Sajid-Ali-Imperial/Contact-Tracing-Wearable-FYP/PCB Design Documents/pcb_fabriacted.png

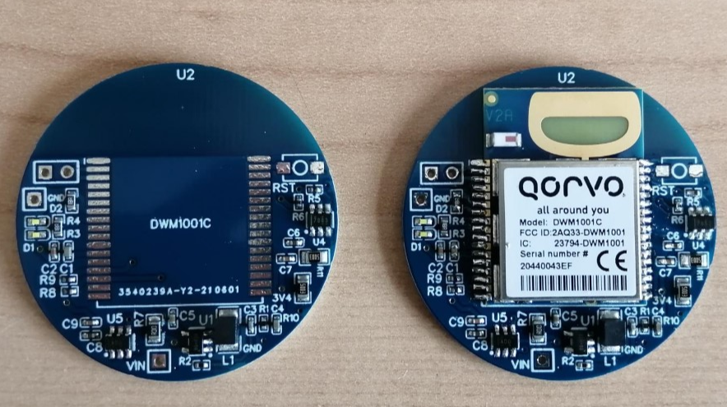
PCB Design Documents/pcb_fabriacted.png
