Sajid-Ali-Imperial/Contact-Tracing-Wearable-FYP/Covid Track App/Screenshots/Home Page 1.png

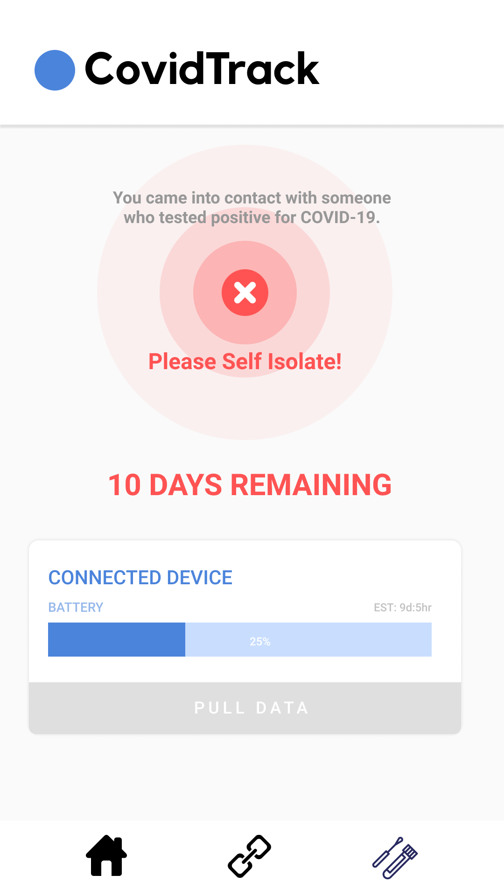
Covid Track App/Screenshots/Home Page 1.png
