Sajid-Ali-Imperial/Contact-Tracing-Wearable-FYP/Covid Track App/Screenshots/Home Page 2.png

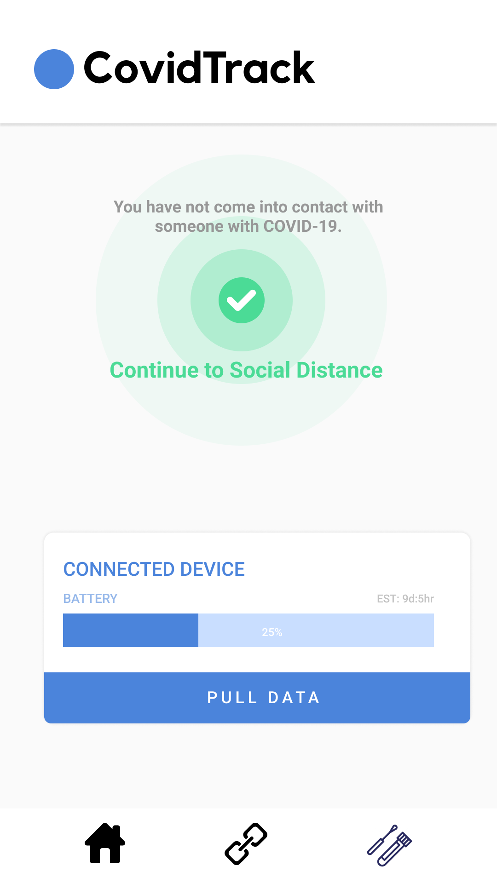
Covid Track App/Screenshots/Home Page 2.png
