Sajid-Ali-Imperial/Contact-Tracing-Wearable-FYP/Covid Track App/Screenshots/Link Device Disconnect.png

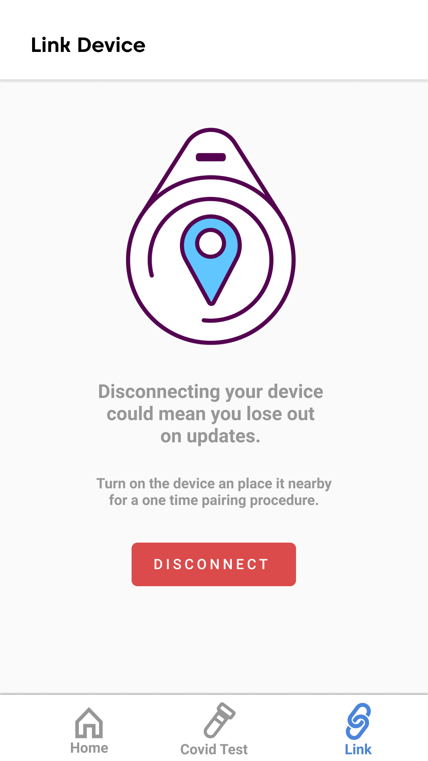
Covid Track App/Screenshots/Link Device Disconnect.png
