Sajid-Ali-Imperial/Contact-Tracing-Wearable-FYP/Covid Track App/Screenshots/Login Page.png

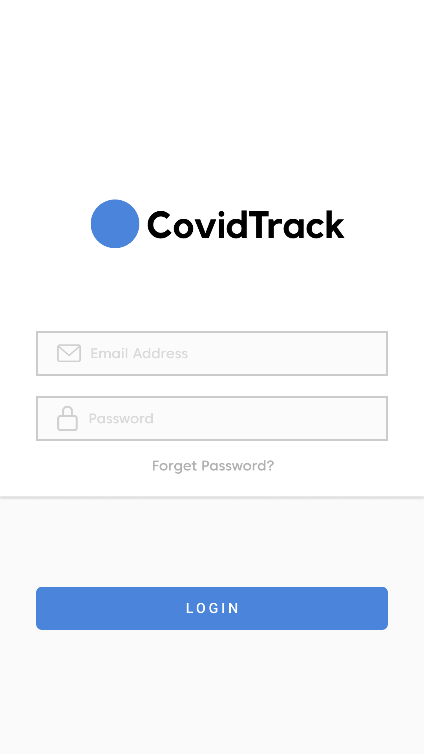
Covid Track App/Screenshots/Login Page.png
