Sajid-Ali-Imperial/Contact-Tracing-Wearable-FYP/Device Casing Model/battery_holder.stl

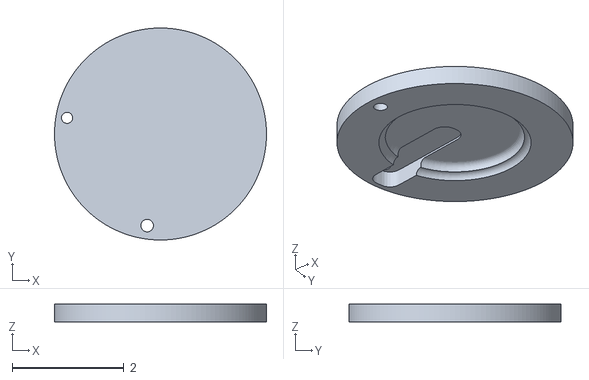
[picture p31: CAD file, 2021-06-16]
Device Casing Model/battery_holder.stl
3.80 x 3.80 x 0.318
