Sajid-Ali-Imperial/Contact-Tracing-Wearable-FYP/Device Casing Model/back.stl

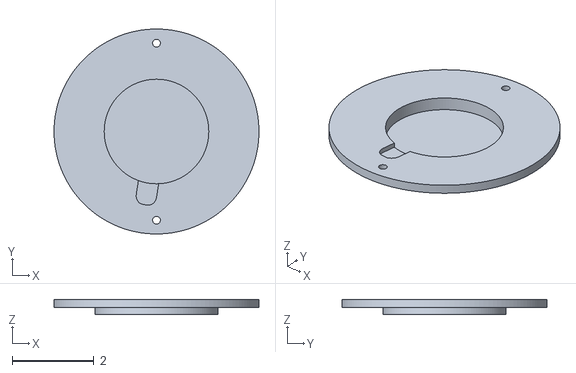
[picture p32: CAD file, 2021-06-16]
Device Casing Model/back.stl
5.00 x 5.00 x 0.367
