Sajid-Ali-Imperial/Contact-Tracing-Wearable-FYP/Device Casing Model/front.stl

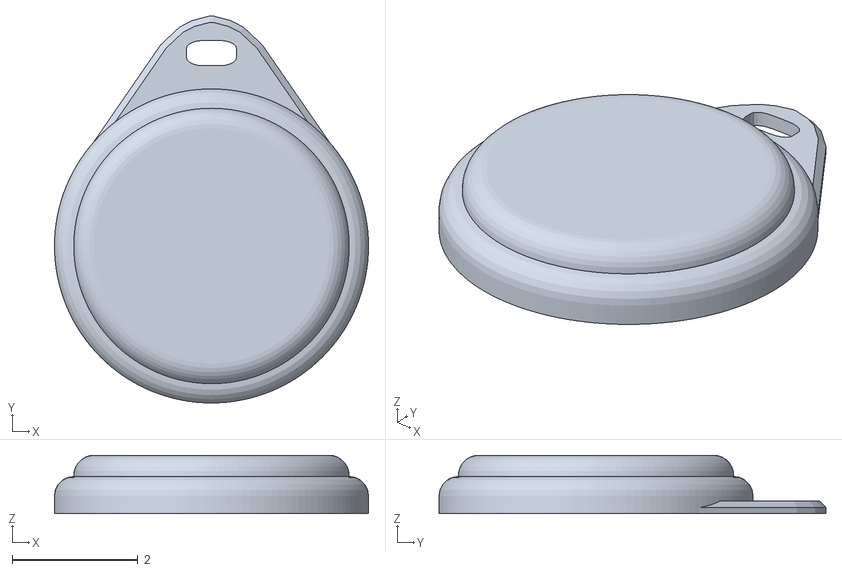
[picture p33: CAD file, 2021-06-16]
Device Casing Model/front.stl
5.00 x 6.16 x 0.93
