Sajid-Ali-Imperial/Contact-Tracing-Wearable-FYP/(list of files, cad)

Other CAD files:
Device Casing Model/device_casing.blend
