Sajid-Ali-Imperial/Contact-Tracing-Wearable-FYP/Covid Track App/Screenshots/Covid Test Input.png

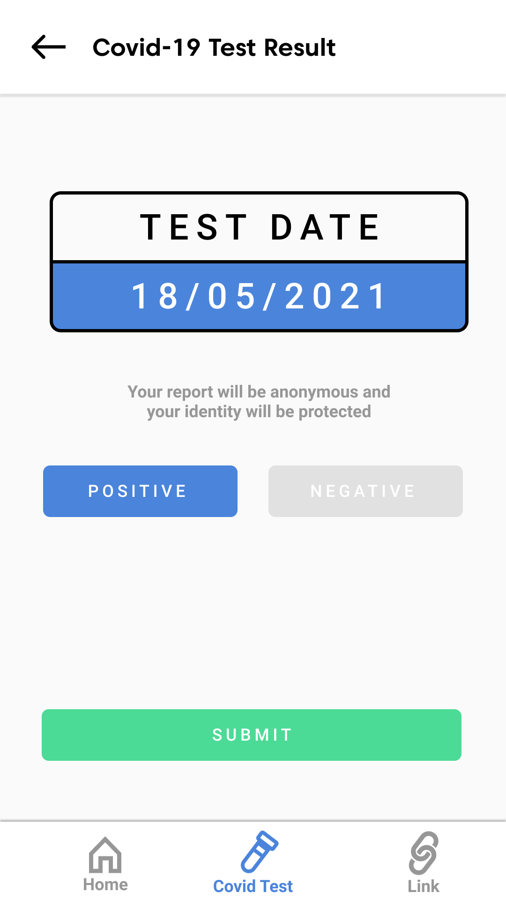
Covid Track App/Screenshots/Covid Test Input.png
