Sajid-Ali-Imperial/Contact-Tracing-Wearable-FYP/Covid Track App/Screenshots/Covid Test Page.png

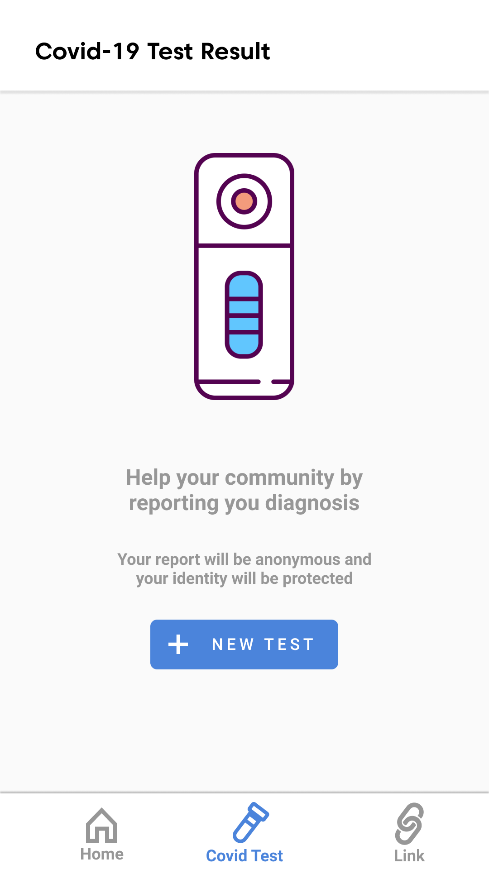
Covid Track App/Screenshots/Covid Test Page.png
