Sajid-Ali-Imperial/Contact-Tracing-Wearable-FYP/PCB Design Documents/Schematic_nRF52 Example Board_2021-06-15.pdf

## DWM1001 MODULE

# BATTERY MONITOR V_SHUNT

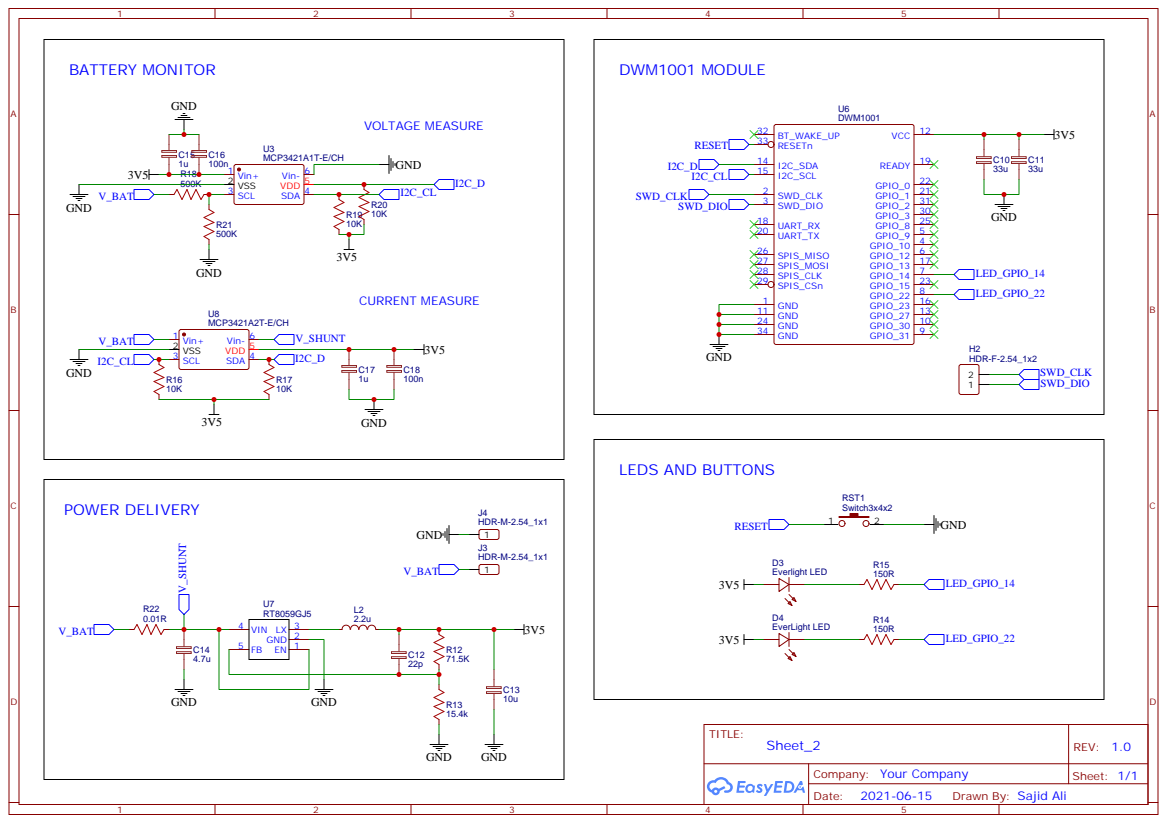
[picture p36: page 1]

Drawn By: Sajid Ali
