Sajid-Ali-Imperial/Contact-Tracing-Wearable-FYP/Device Firmware/export_v0.8_init/src/UWB/uwb.c

#include "uwb.h"

/* Example application name and version to display on console. */
// #define APP_HEADER "\nDWM1001 & Zephyr\n"
// #define APP_NAME "Example 5a - DS TWR INIT\n"
// #define APP_VERSION "Version - 1.4.0\n"
// #define APP_VERSION_NUM 0x010400
// #define APP_LINE "=================\n"

/* Inter-ranging delay period, in milliseconds. */
#define RNG_DELAY_MS 1000

/* Default communication configuration. */
static dwt_config_t config = {                                                                        
    5,               /* Channel number. */
    DWT_PRF_64M,     /* Pulse repetition frequency. */                                                
    DWT_PLEN_128,    /* Preamble length. Used in TX only. */                                           
    DWT_PAC8,        /* Preamble acquisition chunk size. Used in RX only. */                           
    9,               /* TX preamble code. Used in TX only. */                                         
    9,               /* RX preamble code. Used in RX only. */
    1,               /* 0 to use standard SFD, 1 to use non-standard SFD. */                          
    DWT_BR_6M8,      /* Data rate. */
    DWT_PHRMODE_EXT, /* PHY header mode. */
    (129)            /* SFD timeout (preamble length + 1 + SFD length - PAC size). Used in RX only. */           
};

/* Default antenna delay values for 64 MHz PRF. See NOTE 1 below. */
#define TX_ANT_DLY 16436
#define RX_ANT_DLY 16436

/* Frames used in the ranging process. See NOTE 2 below. */
static uint8 tx_poll_msg[] = {0x41, 0x88, 0, 0xCA, 0xDE, 'W', 'A', 'V', 'E', 0x21, 0, 0};
static uint8 rx_resp_msg[] = {0x41, 0x88, 0, 0xCA, 0xDE, 'V', 'E', 'W', 'A', 0x10, 0x02, 0, 0, 0, 0};
static uint8 tx_final_msg[] = {0x41, 0x88, 0, 0xCA, 0xDE, 'W', 'A', 'V', 'E', 0x23, 0, 0, 0, 0, 0, 0, 0, 0, 0, 0, 0, 0, 0, 0};
/* Length of the common part of the message (up to and including the function code, see NOTE 2 below). */
#define ALL_MSG_COMMON_LEN 10
/* Indexes to access some of the fields in the frames defined above. */
#define ALL_MSG_SN_IDX 2
#define FINAL_MSG_POLL_TX_TS_IDX 10
#define FINAL_MSG_RESP_RX_TS_IDX 14
#define FINAL_MSG_FINAL_TX_TS_IDX 18
#define FINAL_MSG_TS_LEN 4
/* Frame sequence number, incremented after each transmission. */
static uint8 frame_seq_nb = 0;

/* Buffer to store received response message.
 * Its size is adjusted to longest frame that this example code is supposed to handle. */
#define RX_BUF_LEN 20
static uint8 rx_buffer[RX_BUF_LEN];

/* Hold copy of status register state here for reference so that it can be examined at a debug breakpoint. */
static uint32 status_reg = 0;

/* UWB microsecond (uus) to device time unit (dtu, around 15.65 ps) conversion factor.
 * 1 uus = 512 / 499.2 �s and 1 �s = 499.2 * 128 dtu. */
#define UUS_TO_DWT_TIME 65536

/* Delay between frames, in UWB microseconds. See NOTE 4 below. */
/* This is the delay from the end of the frame transmission to the enable of the receiver, as programmed for the DW1000's wait for response feature. */
#define POLL_TX_TO_RESP_RX_DLY_UUS 300
/* This is the delay from Frame RX timestamp to TX reply timestamp used for calculating/setting the DW1000's delayed TX function. This includes the
 * frame length of approximately 2.66 ms with above configuration. */
#define RESP_RX_TO_FINAL_TX_DLY_UUS 4000
/* Receive response timeout. See NOTE 5 below. */
#define RESP_RX_TIMEOUT_UUS 6000
/* Preamble timeout, in multiple of PAC size. See NOTE 6 below. */
#define PRE_TIMEOUT 40

/* Time-stamps of frames transmission/reception, expressed in device time units.
 * As they are 40-bit wide, we need to define a 64-bit int type to handle them. */
typedef unsigned long long uint64;
static uint64 poll_tx_ts;
static uint64 resp_rx_ts;
static uint64 final_tx_ts;

/* Declaration of static functions. */
static uint64 get_tx_timestamp_u64(void);
static uint64 get_rx_timestamp_u64(void);
static void final_msg_set_ts(uint8 *ts_field, uint64 ts);

/* Dummy buffer for DW1000 wake-up SPI read. See NOTE 3 below. */
// #define DUMMY_BUFFER_LEN 600
// static uint8 dummy_buffer[DUMMY_BUFFER_LEN];

void uwb_thread(void *arg1, void *ard2, void *arg3)
{
    /* Configure DW1000 SPI */
    openspi();

    /* Reset and initialise DW1000.
     * For initialisation, DW1000 clocks must be temporarily set to crystal speed. After initialisation SPI rate can be increased for optimum
     * performance. */
    reset_DW1000(); /* Target specific drive of RSTn line into DW1000 low for a period. */

    //printf("Attempting to set SLOW RATE \n");
    port_set_dw1000_slowrate();

    printf("Attempting to CALL INIT\n");
    if (dwt_initialise(DWT_LOADUCODE) == DWT_ERROR)
    {
        printf("err - init failed \n");
        while (1)
        { };
    }

    printf("Attempting to SET FAST RATE\n");
    port_set_dw1000_fastrate();

    /* Configure GPIOs to not show TX/RX activity. See NOTE 6 below. */
    //dwt_setlnapamode(DWT_LNA_PA_DISABLE); CBT

    /* Configure DW1000. See NOTE 7 below. */
    printf("Attempting to CONFIGURE\n");
    dwt_configure(&config);

    /* Configure sleep and wake-up parameters. */
    //dwt_configuresleep(DWT_PRESRV_SLEEP | DWT_CONFIG,  DWT_WAKE_CS | DWT_SLP_EN);

    /* Apply default antenna delay value. See NOTE 1 below. */
    dwt_setrxantennadelay(RX_ANT_DLY);
    dwt_settxantennadelay(TX_ANT_DLY);

    /* Set expected response's delay and timeout. See NOTE 4, 5 and 6 below.
     * As this example only handles one incoming frame with always the same delay and timeout, those values can be set here once for all. */
    dwt_setrxaftertxdelay(POLL_TX_TO_RESP_RX_DLY_UUS);
    dwt_setrxtimeout(RESP_RX_TIMEOUT_UUS);

    //NOTE: no use of preamble tmo's yet
    // dwt_setpreambledetecttimeout(PRE_TIMEOUT);

    /* Configure DW1000 LEDs */
    dwt_setleds(1);
    
    int transIdx = 0;

    /* Loop forever initiating ranging exchanges. */
    while (1)
    {
        /* Issue a wake-up in case DW1000 is asleep.
        * Since DW1000 is not woken by the reset line, we could get here with it asleep. Note that this may be true in other examples but we pay special
        * attention here because this example is precisely about sleeping. */
        //dwt_spicswakeup(dummy_buffer, DUMMY_BUFFER_LEN);

        /* Write frame data to DW1000 and prepare transmission. See NOTE 8 below. */
        tx_poll_msg[ALL_MSG_SN_IDX] = frame_seq_nb;
        dwt_writetxdata(sizeof(tx_poll_msg), tx_poll_msg, 0); /* Zero offset in TX buffer. */
        dwt_writetxfctrl(sizeof(tx_poll_msg), 0, 1); /* Zero offset in TX buffer, ranging. */

        printf("Transmitted Message: %d \n", ++transIdx);

        /* Start transmission, indicating that a response is expected so that reception is enabled automatically after the frame is sent and the delay
         * set by dwt_setrxaftertxdelay() has elapsed. */
        dwt_starttx(DWT_START_TX_IMMEDIATE | DWT_RESPONSE_EXPECTED);

        /* We assume that the transmission is achieved correctly, poll for reception of a frame or error/timeout. See NOTE 9 below. */
        while (!((status_reg = dwt_read32bitreg(SYS_STATUS_ID)) & (SYS_STATUS_RXFCG | SYS_STATUS_ALL_RX_TO | SYS_STATUS_ALL_RX_ERR)))
        { };

        /* Increment frame sequence number after transmission of the poll message (modulo 256). */
        frame_seq_nb++;

        if (status_reg & SYS_STATUS_RXFCG)
        {
            uint32 frame_len;

            /* Clear good RX frame event and TX frame sent in the DW1000 status register. */
            dwt_write32bitreg(SYS_STATUS_ID, SYS_STATUS_RXFCG | SYS_STATUS_TXFRS);

            /* A frame has been received, read it into the local buffer. */
            frame_len = dwt_read32bitreg(RX_FINFO_ID) & RX_FINFO_RXFLEN_MASK;
            if (frame_len <= RX_BUF_LEN)
            {
                dwt_readrxdata(rx_buffer, frame_len, 0);
            }

            /* Check that the frame is the expected response from the companion "DS TWR responder" example.
             * As the sequence number field of the frame is not relevant, it is cleared to simplify the validation of the frame. */
            rx_buffer[ALL_MSG_SN_IDX] = 0;
            if (memcmp(rx_buffer, rx_resp_msg, ALL_MSG_COMMON_LEN) == 0)
            {
                uint32 final_tx_time;
                int ret;

                /* Retrieve poll transmission and response reception timestamp. */
                poll_tx_ts = get_tx_timestamp_u64();
                resp_rx_ts = get_rx_timestamp_u64();

                /* Compute final message transmission time. See NOTE 10 below. */
                final_tx_time = (resp_rx_ts + (RESP_RX_TO_FINAL_TX_DLY_UUS * UUS_TO_DWT_TIME)) >> 8;
                dwt_setdelayedtrxtime(final_tx_time);

                /* Final TX timestamp is the transmission time we programmed plus the TX antenna delay. */
                final_tx_ts = (((uint64)(final_tx_time & 0xFFFFFFFEUL)) << 8) + TX_ANT_DLY;

                /* Write all timestamps in the final message. See NOTE 11 below. */
                final_msg_set_ts(&tx_final_msg[FINAL_MSG_POLL_TX_TS_IDX], poll_tx_ts);
                final_msg_set_ts(&tx_final_msg[FINAL_MSG_RESP_RX_TS_IDX], resp_rx_ts);
                final_msg_set_ts(&tx_final_msg[FINAL_MSG_FINAL_TX_TS_IDX], final_tx_ts);

                /* Write and send final message. See NOTE 8 below. */
                tx_final_msg[ALL_MSG_SN_IDX] = frame_seq_nb;
                dwt_writetxdata(sizeof(tx_final_msg), tx_final_msg, 0); /* Zero offset in TX buffer. */
                dwt_writetxfctrl(sizeof(tx_final_msg), 0, 1); /* Zero offset in TX buffer, ranging. */
                ret = dwt_starttx(DWT_START_TX_DELAYED);

                /* If dwt_starttx() returns an error, abandon this ranging exchange and proceed to the next one. See NOTE 12 below. */
                if (ret == DWT_SUCCESS)
                {
                    /* Poll DW1000 until TX frame sent event set. See NOTE 9 below. */
                    while (!(dwt_read32bitreg(SYS_STATUS_ID) & SYS_STATUS_TXFRS))
                    { };

                    /* Clear TXFRS event. */
                    dwt_write32bitreg(SYS_STATUS_ID, SYS_STATUS_TXFRS);

                    printf("success (%u)\n", frame_seq_nb);

                    /* Increment frame sequence number after transmission of the final message (modulo 256). */
                    frame_seq_nb++;
                }else
                {
                    printf("err - tx failed\n");
                }
                
            }
        }
        else
        {
            printf("err - tmo1 (rx failed)\n");
            /* Clear RX error/timeout events in the DW1000 status register. */
            dwt_write32bitreg(SYS_STATUS_ID, SYS_STATUS_ALL_RX_TO | SYS_STATUS_ALL_RX_ERR);

            /* Reset RX to properly reinitialise LDE operation. */
            dwt_rxreset();
        }

        //dwt_entersleep();
        /* Execute a delay between ranging exchanges. */
        Sleep(RNG_DELAY_MS);
    }
}


static uint64 get_tx_timestamp_u64(void)
{
    uint8 ts_tab[5];
    uint64 ts = 0;
    int i;
    dwt_readtxtimestamp(ts_tab);
    for (i = 4; i >= 0; i--)
    {
        ts <<= 8;
        ts |= ts_tab[i];
    }
    return ts;
}


static uint64 get_rx_timestamp_u64(void)
{
    uint8 ts_tab[5];
    uint64 ts = 0;
    int i;
    dwt_readrxtimestamp(ts_tab);
    for (i = 4; i >= 0; i--)
    {
        ts <<= 8;
        ts |= ts_tab[i];
    }
    return ts;
}


static void final_msg_set_ts(uint8 *ts_field, uint64 ts)
{
    int i;
    for (i = 0; i < FINAL_MSG_TS_LEN; i++)
    {
        ts_field[i] = (uint8) ts;
        ts >>= 8;
    }
}
