Sajid-Ali-Imperial/Contact-Tracing-Wearable-FYP/Device Firmware/export_v0.9_rsp/src/UWB/uwb.h

#ifndef UWB_SCRIPT
#define UWB_SCRIPT

#include <string.h>

#include "deca_device_api.h"
#include "deca_regs.h"
#include "deca_spi.h"
#include "port.h"
#include <stdio.h>


void start_ds_rsp();

void init_uwb();



#endif
