Sajid-Ali-Imperial/Contact-Tracing-Wearable-FYP/Device Firmware/test_battery_service/src/main.c

#include <zephyr/types.h>
#include <stddef.h>
#include <string.h>
#include <errno.h>
#include <misc/printk.h>
#include <misc/byteorder.h>
#include <zephyr.h>

#include <settings/settings.h>

#include <bluetooth/bluetooth.h>
#include <bluetooth/hci.h>
#include <bluetooth/conn.h>
#include <bluetooth/uuid.h>
#include <bluetooth/gatt.h>

#include "bas.h"



static const struct bt_data ad[] = {
	BT_DATA_BYTES(BT_DATA_FLAGS, (BT_LE_AD_GENERAL | BT_LE_AD_NO_BREDR)),
	BT_DATA_BYTES(BT_DATA_UUID16_ALL,
		      0x0d, 0x18, 0x0f, 0x18, 0x05, 0x18),
	BT_DATA_BYTES(BT_DATA_UUID128_ALL,
		      0xf0, 0xde, 0xbc, 0x9a, 0x78, 0x56, 0x34, 0x12,
		      0x78, 0x56, 0x34, 0x12, 0x78, 0x56, 0x34, 0x12),
};

static void connected(struct bt_conn *conn, u8_t err)
{
	if (err) {
		printk("Connection failed (err %u)\n", err);
	} else {
		printk("Connected\n");
	}
}

static void disconnected(struct bt_conn *conn, u8_t reason)
{
	printk("Disconnected (reason %u)\n", reason);
}

static struct bt_conn_cb conn_callbacks = {
	.connected = connected,
	.disconnected = disconnected,
};

static void bt_ready(int err)
{
	if (err) {
		printk("Bluetooth init failed (err %d)\n", err);
		return;
	}

	printk("Bluetooth initialized\n");

	bas_init();

	if (IS_ENABLED(CONFIG_SETTINGS)) {
		settings_load();
	}

	err = bt_le_adv_start(BT_LE_ADV_CONN_NAME, ad, ARRAY_SIZE(ad), NULL, 0);
	if (err) {
		printk("Advertising failed to start (err %d)\n", err);
		return;
	}

	printk("Advertising successfully started\n");
}

static void auth_passkey_display(struct bt_conn *conn, unsigned int passkey)
{
	char addr[BT_ADDR_LE_STR_LEN];

	bt_addr_le_to_str(bt_conn_get_dst(conn), addr, sizeof(addr));

	printk("Passkey for %s: %06u\n", addr, passkey);
}

static void auth_cancel(struct bt_conn *conn)
{
	char addr[BT_ADDR_LE_STR_LEN];

	bt_addr_le_to_str(bt_conn_get_dst(conn), addr, sizeof(addr));

	printk("Pairing cancelled: %s\n", addr);
}

static struct bt_conn_auth_cb auth_cb_display = {
	.passkey_display = auth_passkey_display,
	.passkey_entry = NULL,
	.cancel = auth_cancel,
};

void main(void)
{
	int err;

	err = bt_enable(bt_ready);
	if (err) {
		printk("Bluetooth init failed (err %d)\n", err);
		return;
	}

	bt_conn_cb_register(&conn_callbacks);
	bt_conn_auth_cb_register(&auth_cb_display);

	/* Implement notification. At the moment there is no suitable way
	 * of starting delayed work so we do it here
	 */
	while (1) {
		k_sleep(MSEC_PER_SEC);

		/* Battery level simulation */
		bas_notify();

	}
}
